mondaladi/SmartBenchPSU/(commit log)

2025-02-16 Create PSU_AnalogPWM.ino
    Does not use the PWM.h library
2025-02-16 Create PSU_PWM.h.ino
    Uses the PWM.h library
2025-02-16 Update PSU_AnalogPWM.ino
    Without PWM.h library
2025-02-16 Gerber files
2025-02-16 PCB Design_true-scale
    For home PCB fabrication
